jonaspluess/ultrasonic_phased_array/documentation/fachbericht/11_danksagung.tex

In erster Linie möchten wir uns bei unseren Projektbetreuern Herrn Matthias Meier und Herrn Prof. Dr. Richard Gut für Ihre grossartige Unterstützung während der vergangenen zwei Projekten bedanken. Mit ihren guten Ideen, der konstruktiven Kritik, dem Fachwissen und der unermüdlichen Hilfe wenn irgendwo Probleme auftraten haben sie massgeblich zum erfolgreichen und zufriedenstellenden Abschluss der Bachelorarbeit beigetragen.

Auch bei Frau Anita Gertiser möchten wir uns für das ausdauernde Korrekturlesen und die Unterstützung beim Strukturieren des Fachberichtes ganz herzlich bedanken.

Ebenfalls bei Herrn Christoph Biel möchten wir uns bedanken. Material- und PCB-Bestellungen wurden von ihm jeweils innert rekordverdächtig kurzer Zeit bearbeitet. Auch bei allen anderen Anliegen bezüglich Messgeräten und Bauteilen hat er uns stets ausgeholfen und mit seiner positiven Einstellung zu einem guten Arbeitsklima beigetragen.

Besonders möchten wir uns auch bei Herrn Christoph Mijnssen für die interessierte Teilnahme bedanken. Mit seinem Fachwissen in Gebieten der Akustik hat er uns stets unterstützt und auf neue Ideen gebracht. Auch spontane Bauteilbestellungen konnten wir dank ihm jederzeit erledigen. Ebenfalls möchten wir uns für das geduldige Gegenlesen des Fachberichtes bedanken.

Zudem möchten wir uns bei Herrn Prof. Dr. Urs Bopp und bei Herrn Peter Hug bedanken für die freundliche Erlaubnis, den reflexionsarmen Halbraum an der FHNW für Messungen benutzen zu können.
