jonaspluess/ultrasonic_phased_array/documentation/fachbericht/graphics/image_hardware_spannungsfolger.png

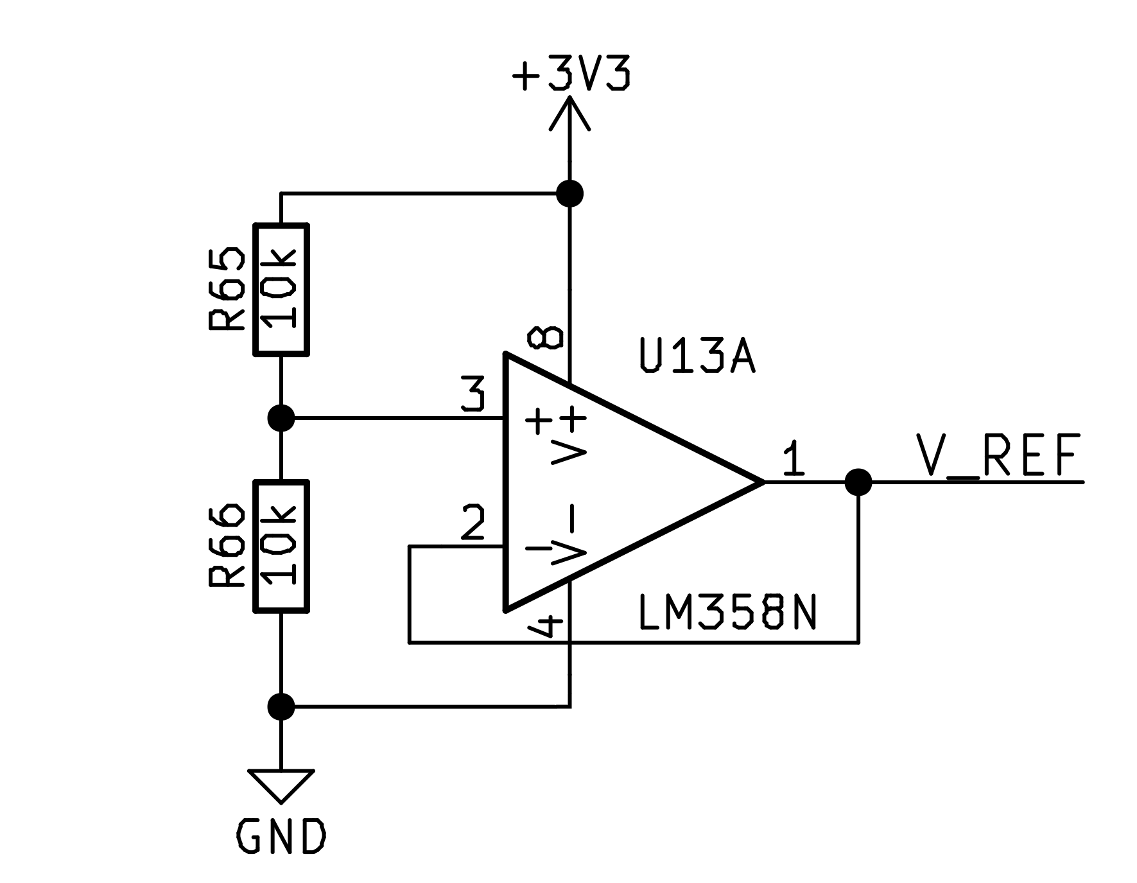
documentation/fachbericht/graphics/image_hardware_spannungsfolger.png
