jonaspluess/ultrasonic_phased_array/documentation/fachbericht/measurements/09_characteristic_aperture.txt

# 10 Grad, 8 Bursts
#	rect	cos	cos2	gauss
################################################################################
-45	0.544	0.287	0.332	0.325
-44	0.537	0.276	0.314	0.320
-43	0.503	0.277	0.303	0.297
-42	0.440	0.246	0.283	0.288
-41	0.402	0.241	0.273	0.275
-40	0.366	0.258	0.284	0.277
-39	0.311	0.236	0.273	0.288
-38	0.292	0.236	0.269	0.287
-37	0.344	0.244	0.284	0.293
-36	0.360	0.264	0.280	0.288
-35	0.434	0.280	0.277	0.267
-34	0.493	0.284	0.271	0.257
-33	0.537	0.304	0.276	0.273
-32	0.577	0.313	0.283	0.280
-31	0.591	0.327	0.297	0.298
-30	0.578	0.313	0.311	0.298
-29	0.537	0.313	0.317	0.313
-28	0.502	0.308	0.318	0.322
-27	0.434	0.293	0.317	0.320
-26	0.343	0.280	0.320	0.320
-25	0.293	0.288	0.305	0.320
-24	0.273	0.287	0.324	0.320
-23	0.337	0.284	0.316	0.312
-22	0.423	0.298	0.320	0.324
-21	0.503	0.293	0.332	0.320
-20	0.587	0.307	0.331	0.316
-19	0.623	0.303	0.337	0.301
-18	0.680	0.300	0.363	0.307
-17	0.666	0.338	0.374	0.310
-16	0.609	0.378	0.376	0.320
-15	0.516	0.407	0.353	0.320
-14	0.409	0.446	0.344	0.326
-13	0.422	0.485	0.342	0.327
-12	0.443	0.497	0.331	0.320
-11	0.531	0.520	0.336	0.320
-10	0.728	0.516	0.347	0.320
-9	0.927	0.472	0.357	0.408
-8	1.08	0.448	0.404	0.523
-7	1.16	0.433	0.511	0.600
-6	1.15	0.415	0.667	0.755
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
