jonaspluess/ultrasonic_phased_array/documentation/fachbericht/measurements/09_characteristic_module.txt

# 8 Bursts
################################################################################
-45	0.409
-44	0.404
-43	0.440
-42	0.440
-41	0.456
-40	0.471
-39	0.512
-38	0.514
-37	0.515
-36	0.520
-35	0.529
-34	0.532
-33	0.547
-32	0.573
-31	0.552
-30	0.578
-29	0.600
-28	0.613
-27	0.619
-26	0.621
-25	0.662
-24	0.676
-23	0.698
-22	0.711
-21	0.729
-20	0.753
-19	0.753
-18	0.754
-17	0.741
-16	0.741
-15	0.724
-14	0.705
-13	0.697
-12	0.693
-11	0.683
-10	0.677
-9	0.674
-8	0.680
-7	0.655
-6	0.643
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
