jonaspluess/ultrasonic_phased_array/documentation/fachbericht/measurements/09_characteristic_rect.txt

# 8 Bursts
#	0 deg	10 deg	20 deg	30 deg
################################################################################
-45	0.403	0.544	0.362	0.525
-44	0.456	0.537	0.352	0.442
-43	0.520	0.503	0.332	0.381
-42	0.560	0.440	0.320	0.423
-41	0.577	0.402	0.362	0.487
-40	0.552	0.366	0.402	0.555
-39	0.514	0.311	0.443	0.567
-38	0.476	0.292	0.496	0.557
-37	0.414	0.344	0.521	0.526
-36	0.359	0.360	0.543	0.524
-35	0.360	0.434	0.583	0.566
-34	0.368	0.493	0.581	0.584
-33	0.415	0.537	0.543	0.572
-32	0.440	0.577	0.517	0.541
-31	0.520	0.591	0.446	0.482
-30	0.600	0.578	0.383	0.442
-29	0.672	0.537	0.336	0.449
-28	0.684	0.502	0.320	0.466
-27	0.688	0.434	0.342	0.476
-26	0.680	0.343	0.373	0.451
-25	0.627	0.293	0.406	0.402
-24	0.544	0.273	0.440	0.333
-23	0.440	0.337	0.492	0.292
-22	0.360	0.423	0.527	0.308
-21	0.257	0.503	0.540	0.351
-20	0.317	0.587	0.557	0.397
-19	0.477	0.623	0.548	0.434
-18	0.640	0.680	0.517	0.422
-17	0.845	0.666	0.455	0.367
-16	0.992	0.609	0.376	0.322
-15	1.09	0.516	0.286	0.323
-14	1.14	0.409	0.311	0.382
-13	1.09	0.422	0.366	0.533
-12	1.00	0.443	0.444	0.601
-11	0.827	0.531	0.551	0.633
-10	0.600	0.728	0.617	0.616
-9	0.473	0.927	0.653	0.571
-8	0.763	1.08	0.622	0.475
-7	1.20	1.16	0.568	0.306
-6	1.72	1.15	0.457	0.295
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
