jonaspluess/ultrasonic_phased_array/documentation/fachbericht/graphics/plot_test_characteristic_aperture_0_cartesian.png

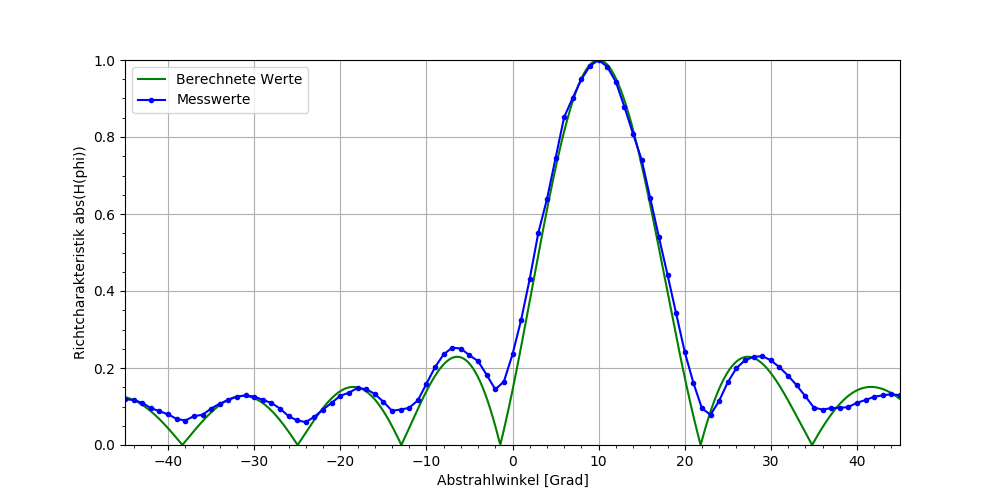
documentation/fachbericht/graphics/plot_test_characteristic_aperture_0_cartesian.png
