jonaspluess/ultrasonic_phased_array/documentation/fachbericht/graphics/plot_test_characteristic_module.png

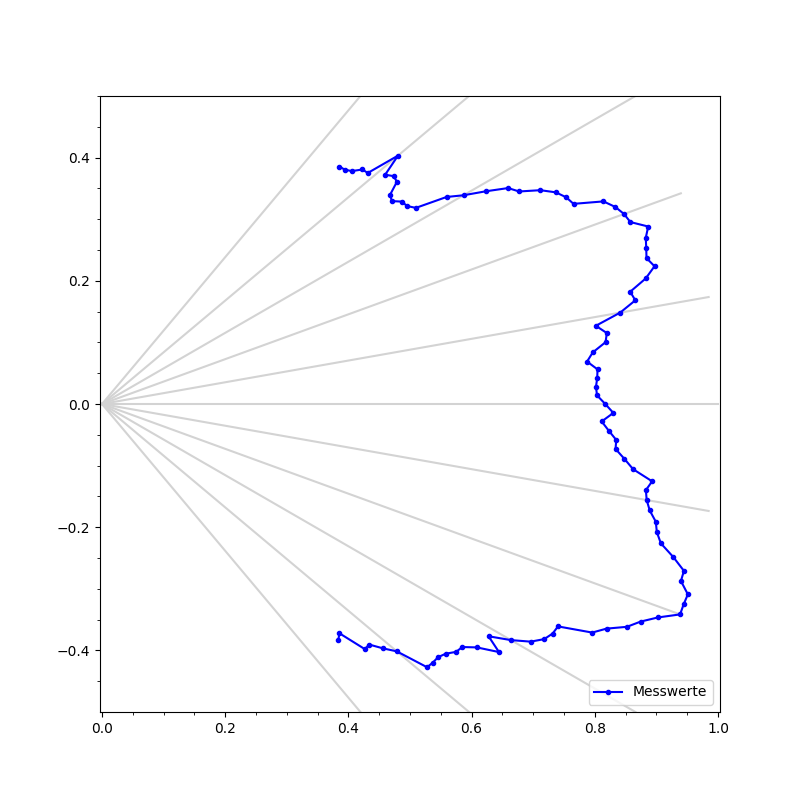
documentation/fachbericht/graphics/plot_test_characteristic_module.png
