jonaspluess/ultrasonic_phased_array/documentation/fachbericht/graphics/plot_test_characteristic_rect_30_cartesian_log.png

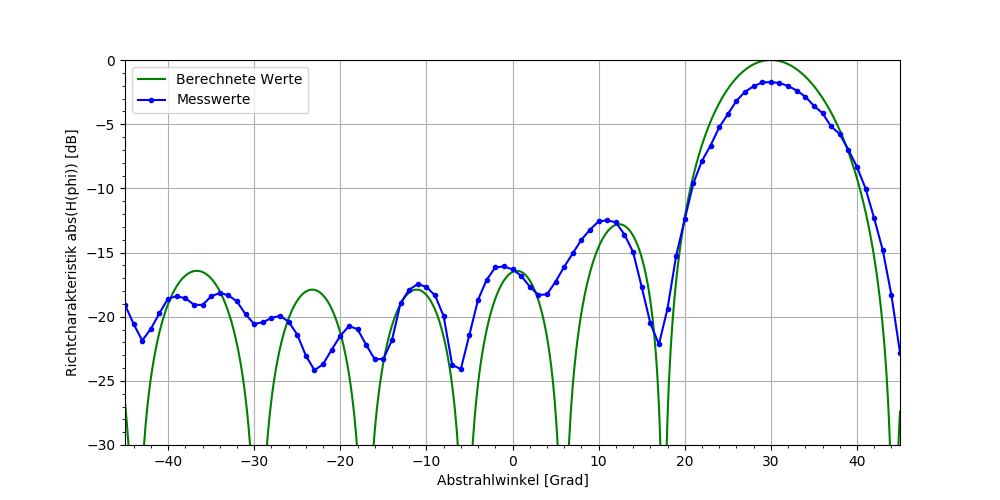
documentation/fachbericht/graphics/plot_test_characteristic_rect_30_cartesian_log.png
