jonaspluess/ultrasonic_phased_array/hardware/external_module/ir_adapter/plot/pcb-B.Cu.pdf

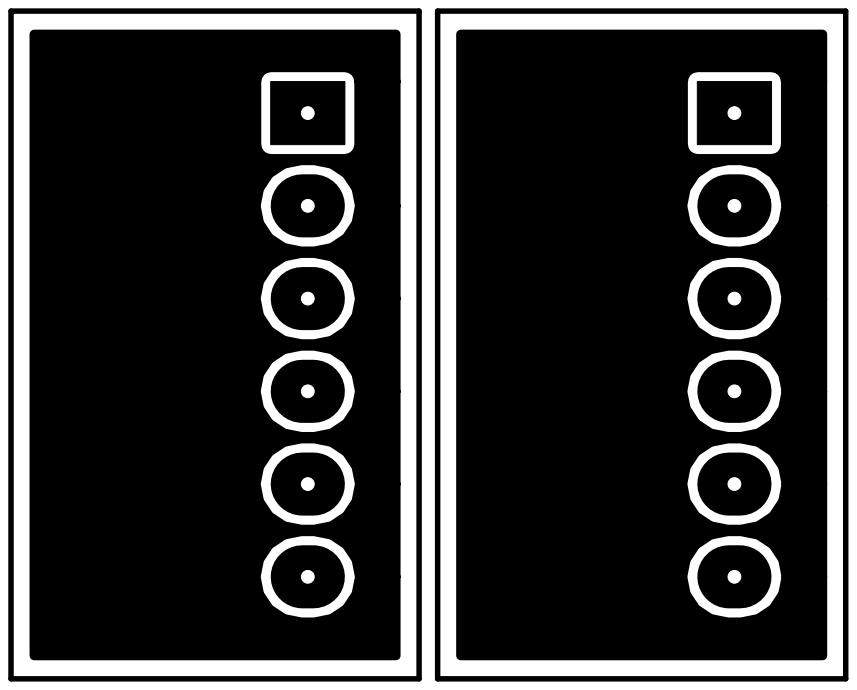
[picture p97: page 1]
