jonaspluess/ultrasonic_phased_array/hardware/external_module/ir_adapter/plot/pcb-F.Cu.pdf

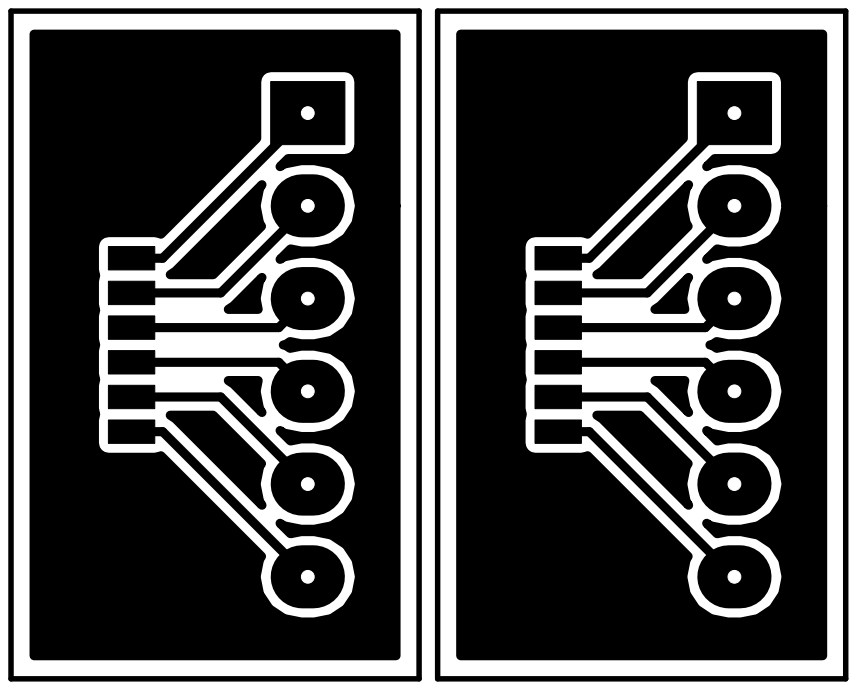
[picture p98: page 1]
