jonaspluess/ultrasonic_phased_array/documentation/simulationen/ltspice_simulation/P6.asc

C1: cap; 100n
C2: cap; 100n
C3: cap; 100n
C4: cap; 100n
R1: res; 1.2e3
R2: res; 20k
R3: res; 100
R4: res; 100
R5: res; 10k
R6: res; 100
U1: opamp2; OPA350
U2: opamp2; OPA350
V1: voltage; SINE(0 1e-3 40e3 0 0 0 40)
V2: voltage; 3.3; Rser=0.01
V3: voltage; 1.65; Rser=0.01
Named nets: 0, piezo, 3.3V, v_ref, out_ch1
.tran 1e-3
.INCLUDE OPA350.mod
