jonaspluess/ultrasonic_phased_array/hardware/ultrasonic_controller_v0.2/pcb.kicad_pcb

## KiCad design hardware/ultrasonic_controller_v0.2/pcb.kicad_pcb (2017-04-01)

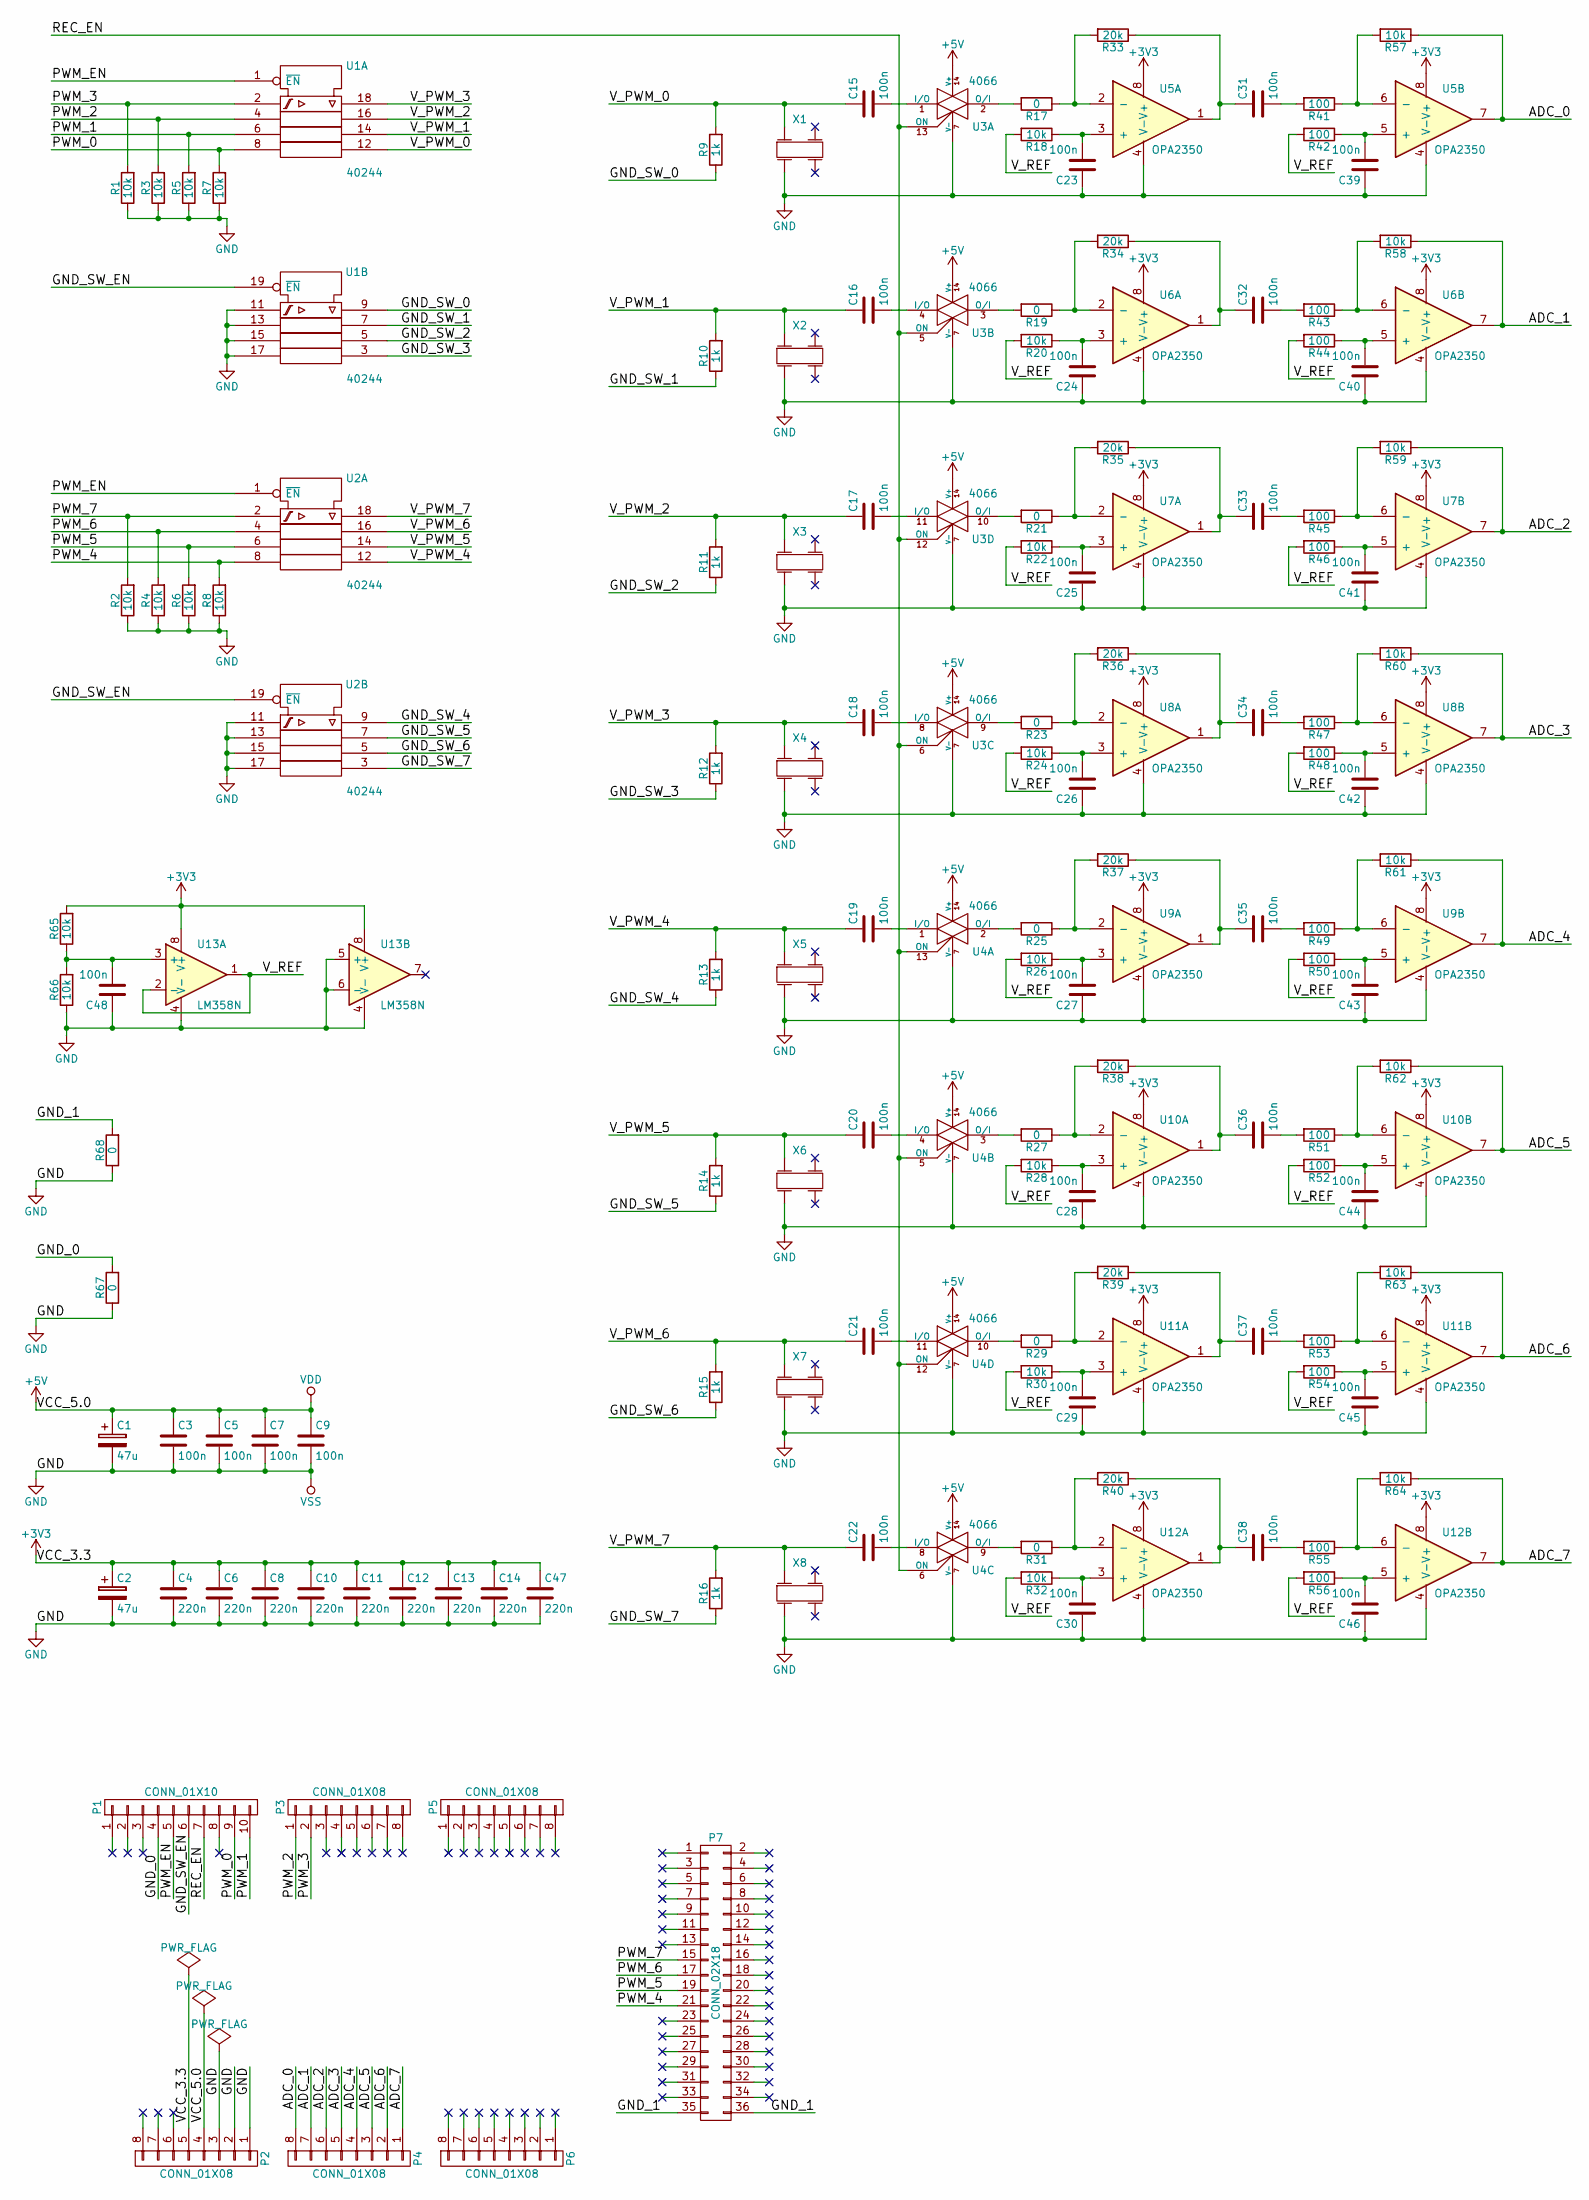
[picture p99: schematic pcb.sch]

Parts:
C1, C2: 47u; c_elec_6.3x5.8
C3, C5, C7, C9, C15, C16, C17, C18, C19, C20, C21, C22, C23, C24, C25, C26, C27, C28, C29, C30, C31, C32, C33, C34, C35, C36, C37, C38, C39, C40, C41, C42, C43, C44, C45, C46, C48: 100n; C_0805
C4, C6, C8, C10, C11, C12, C13, C14, C47: 220n; C_0805
P1: CONN_01X10; Pin_Header_Straight_1x10
P2, P3, P4, P5, P6: CONN_01X08; Pin_Header_Straight_1x08
P7: CONN_02X18; Pin_Header_Straight_2x18
R1, R2, R3, R4, R5, R6, R7, R8, R18, R20, R22, R24, R26, R28, R30, R32, R57, R58, R59, R60, R61, R62, R63, R64, R65, R66: 10k; R_0805
R9, R10, R11, R12, R13, R14, R15, R16: 1k; R_0805
R17, R19, R21, R23, R25, R27, R29, R31, R67, R68: 0; R_0805
R33, R34, R35, R36, R37, R38, R39, R40: 20k; R_0805
R41, R42, R43, R44, R45, R46, R47, R48, R49, R50, R51, R52, R53, R54, R55, R56: 100; R_0805
U1, U2: 40244; SOIC-20W_7.5x12.8mm_Pitch1.27mm
U3, U4: 4066; SOIC-14_N
U5, U6, U7, U8, U9, U10, U11, U12: OPA2350; SOIC-8_3.9x4.9mm_Pitch1.27mm
U13: LM358N; SOIC-8_3.9x4.9mm_Pitch1.27mm
X1, X2, X3, X4, X5, X6, X7, X8: PiezoelectricCrystal-TwoPairsOfelectrodes_EN60617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; murata_ultrasonic_transducer

Connections:
+3V3: C2.1, C4.1, C6.1, C8.1, C10.1, C11.1, C12.1, C13.1, C14.1, C47.1, P2.5, R65.2, U5.8 (V+), U6.8 (V+), U7.8 (V+), U8.8 (V+), U9.8 (V+), U10.8 (V+), U11.8 (V+), U12.8 (V+), U13.8 (V+)
+5V: C1.1, C3.1, C5.1, C7.1, C9.1, P2.4, U1.20 (Vdd), U2.20 (Vdd), U3.14 (V+), U4.14 (V+)
/ADC_0: P4.8, R57.1, U5.7
/ADC_1: P4.7, R58.1, U6.7
/ADC_2: P4.6, R59.1, U7.7
/ADC_3: P4.5, R60.1, U8.7
/ADC_4: P4.4, R61.1, U9.7
/ADC_5: P4.3, R62.1, U10.7
/ADC_6: P4.2, R63.1, U11.7
/ADC_7: P4.1, R64.1, U12.7
/GND_0: P1.4, R67.2
/GND_1: P7.35, P7.36, R68.2
/GND_SW_0: R9.1, U1.9
/GND_SW_1: R10.1, U1.7
/GND_SW_2: R11.1, U1.5
/GND_SW_3: R12.1, U1.3
/GND_SW_4: R13.1, U2.9
/GND_SW_5: R14.1, U2.7
/GND_SW_6: R15.1, U2.5
/GND_SW_7: R16.1, U2.3
/GND_SW_EN: P1.6, U1.19 (~EN), U2.19 (~EN)
/PWM_0: P1.9, R7.2, U1.8
/PWM_1: P1.10, R5.2, U1.6
/PWM_2: P3.1, R3.2, U1.4
/PWM_3: P3.2, R1.2, U1.2
/PWM_4: P7.21, R8.2, U2.8
/PWM_5: P7.19, R6.2, U2.6
/PWM_6: P7.17, R4.2, U2.4
/PWM_7: P7.15, R2.2, U2.2
/PWM_EN: P1.5, U1.1 (~EN), U2.1 (~EN)
/REC_EN: P1.7, U3.5 (ON), U3.6 (ON), U3.12 (ON), U3.13 (ON), U4.5 (ON), U4.6 (ON), U4.12 (ON), U4.13 (ON)
/V_PWM_0: C15.1, R9.2, U1.12, X1.1
/V_PWM_1: C16.1, R10.2, U1.14, X2.1
/V_PWM_2: C17.1, R11.2, U1.16, X3.1
/V_PWM_3: C18.1, R12.2, U1.18, X4.1
/V_PWM_4: C19.1, R13.2, U2.12, X5.1
/V_PWM_5: C20.1, R14.2, U2.14, X6.1
/V_PWM_6: C21.1, R15.2, U2.16, X7.1
/V_PWM_7: C22.1, R16.2, U2.18, X8.1
/V_REF: R18.2, R20.2, R22.2, R24.2, R26.2, R28.2, R30.2, R32.2, R42.2, R44.2, R46.2, R48.2, R50.2, R52.2, R54.2, R56.2, U13.1, U13.2 (-)
GND: C1.2, C2.2, C3.2, C4.2, C5.2, C6.2, C7.2, C8.2, C9.2, C10.2, C11.2, C12.2, C13.2, C14.2, C23.1, C24.1, C25.1, C26.1, C27.1, C28.1, C29.1, C30.1, C39.1, C40.1, C41.1, C42.1, C43.1, C44.1, C45.1, C46.1, C47.2, C48.1, P2.1, P2.2, P2.3, R1.1, R2.1, R3.1, R4.1, R5.1, R6.1, R7.1, R8.1, R66.1, R67.1, R68.1, U1.10 (Vss), U1.11, U1.13, U1.15, U1.17, U2.10 (Vss), U2.11, U2.13, U2.15, U2.17, U3.7 (V-), U4.7 (V-), U5.4 (V-), U6.4 (V-), U7.4 (V-), U8.4 (V-), U9.4 (V-), U10.4 (V-), U11.4 (V-), U12.4 (V-), U13.4 (V-), U13.5 (+), U13.6 (-), X1.3, X2.3, X3.3, X4.3, X5.3, X6.3, X7.3, X8.3
unnamed: C15.2, U3.1 (I/O)
unnamed: C16.2, U3.4 (I/O)
unnamed: C17.2, U3.11 (I/O)
unnamed: C18.2, U3.8 (I/O)
unnamed: C19.2, U4.1 (I/O)
unnamed: C20.2, U4.4 (I/O)
unnamed: C21.2, U4.11 (I/O)
unnamed: C22.2, U4.8 (I/O)
unnamed: C23.2, R18.1, U5.3 (+)
unnamed: C24.2, R20.1, U6.3 (+)
unnamed: C25.2, R22.1, U7.3 (+)
unnamed: C26.2, R24.1, U8.3 (+)
unnamed: C27.2, R26.1, U9.3 (+)
unnamed: C28.2, R28.1, U10.3 (+)
unnamed: C29.2, R30.1, U11.3 (+)
unnamed: C30.2, R32.1, U12.3 (+)
unnamed: C31.1, R33.1, U5.1
unnamed: C31.2, R41.2
unnamed: C32.1, R34.1, U6.1
unnamed: C32.2, R43.2
unnamed: C33.1, R35.1, U7.1
unnamed: C33.2, R45.2
unnamed: C34.1, R36.1, U8.1
unnamed: C34.2, R47.2
unnamed: C35.1, R37.1, U9.1
unnamed: C35.2, R49.2
unnamed: C36.1, R38.1, U10.1
unnamed: C36.2, R51.2
unnamed: C37.1, R39.1, U11.1
unnamed: C37.2, R53.2
unnamed: C38.1, R40.1, U12.1
unnamed: C38.2, R55.2
unnamed: C39.2, R42.1, U5.5 (+)
unnamed: C40.2, R44.1, U6.5 (+)
unnamed: C41.2, R46.1, U7.5 (+)
unnamed: C42.2, R48.1, U8.5 (+)
unnamed: C43.2, R50.1, U9.5 (+)
unnamed: C44.2, R52.1, U10.5 (+)
unnamed: C45.2, R54.1, U11.5 (+)
unnamed: C46.2, R56.1, U12.5 (+)
unnamed: C48.2, R65.1, R66.2, U13.3 (+)
unnamed: R17.1, R33.2, U5.2 (-)
unnamed: R17.2, U3.2 (O/I)
unnamed: R19.1, R34.2, U6.2 (-)
unnamed: R19.2, U3.3 (O/I)
unnamed: R21.1, R35.2, U7.2 (-)
unnamed: R21.2, U3.10 (O/I)
unnamed: R23.1, R36.2, U8.2 (-)
unnamed: R23.2, U3.9 (O/I)
unnamed: R25.1, R37.2, U9.2 (-)
unnamed: R25.2, U4.2 (O/I)
unnamed: R27.1, R38.2, U10.2 (-)
unnamed: R27.2, U4.3 (O/I)
unnamed: R29.1, R39.2, U11.2 (-)
unnamed: R29.2, U4.10 (O/I)
unnamed: R31.1, R40.2, U12.2 (-)
unnamed: R31.2, U4.9 (O/I)
unnamed: R41.1, R57.2, U5.6 (-)
unnamed: R43.1, R58.2, U6.6 (-)
unnamed: R45.1, R59.2, U7.6 (-)
unnamed: R47.1, R60.2, U8.6 (-)
unnamed: R49.1, R61.2, U9.6 (-)
unnamed: R51.1, R62.2, U10.6 (-)
unnamed: R53.1, R63.2, U11.6 (-)
unnamed: R55.1, R64.2, U12.6 (-)

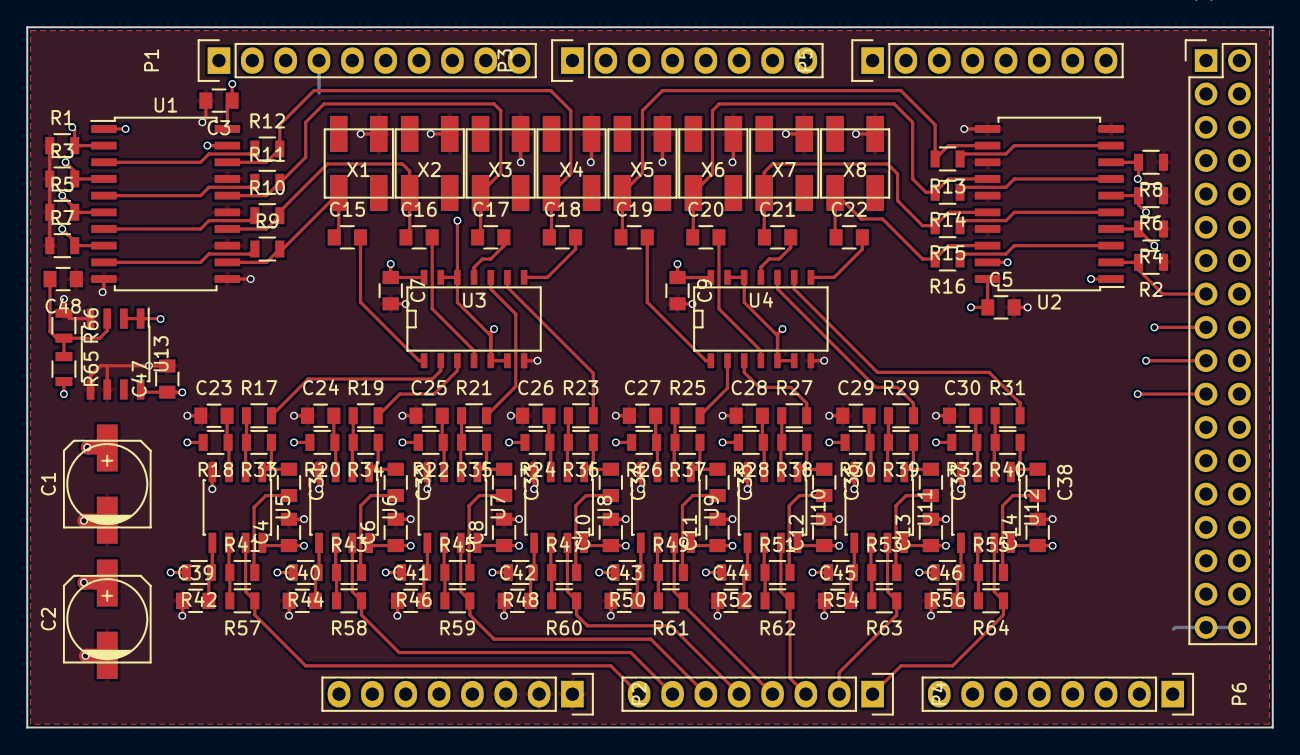
[picture p100: board hardware/ultrasonic_controller_v0.2/pcb.kicad_pcb from above]

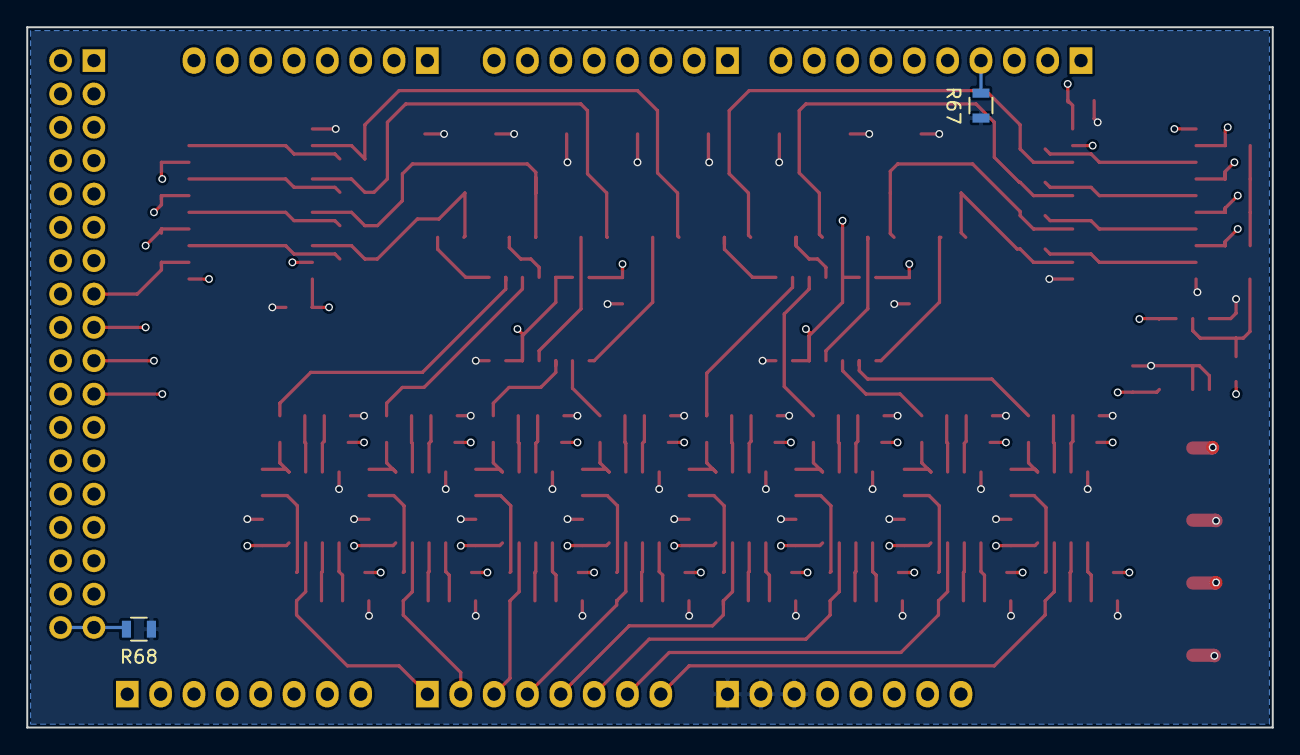
[picture p101: board hardware/ultrasonic_controller_v0.2/pcb.kicad_pcb from below]

Board: 4 copper layers, 94.9 x 53.3 mm, 144 parts (2 on the bottom side), 106 nets.
