jonaspluess/ultrasonic_phased_array/hardware/ultrasonic_controller_v0.1/ultrasonic_controller.kicad_pcb

## KiCad design hardware/ultrasonic_controller_v0.1/ultrasonic_controller.kicad_pcb (2017-04-01, an earlier design)

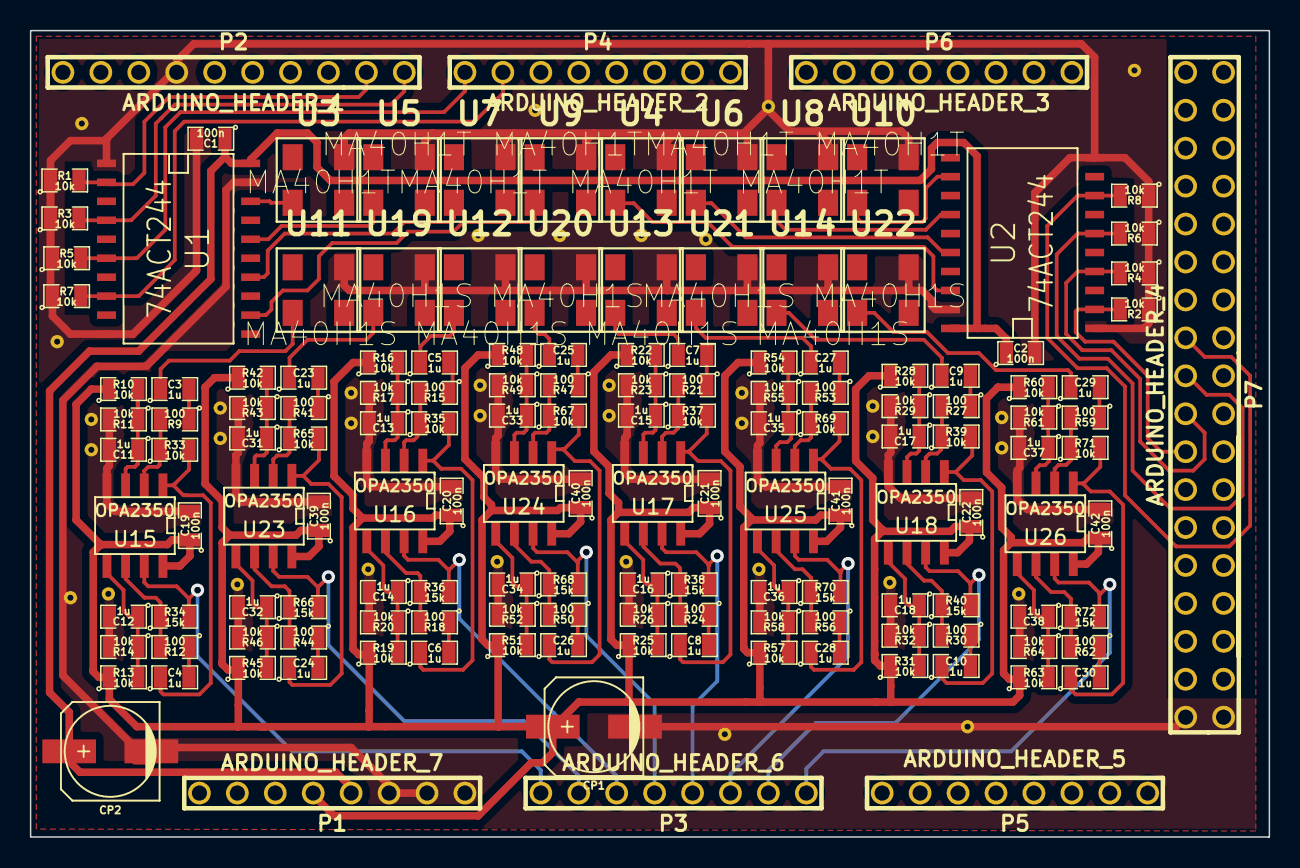
[picture p102: board ultrasonic_controller.kicad_pcb from above]

Board: 2 copper layers, 82.9 x 54.0 mm, 188 parts (0 on the bottom side), 91 nets.

Parts:
C1, C2, C19, C20, C21, C22, C39, C40, C41, C42: 100n; SM0805
C3, C4, C5, C6, C7, C8, C9, C10, C11, C12, C13, C14, C15, C16, C17, C18, C23, C24, C25, C26, C27, C28, C29, C30, C31, C32, C33, C34, C35, C36, C37, C38: 1u; SM0805
CP1, CP2: 10u; c_elec_6.3x5.8
GroundVia: VAL**; GroundVia
GroundVia#2, GroundVia#3, GroundVia#4, GroundVia#5, GroundVia#6, GroundVia#7, GroundVia#8, GroundVia#9, GroundVia#10, GroundVia#11, GroundVia#12, GroundVia#13, GroundVia#14, GroundVia#15, GroundVia#16, GroundVia#17, GroundVia#18, GroundVia#19, GroundVia#20, GroundVia#21, GroundVia#22, GroundVia#23, GroundVia#24, GroundVia#25, GroundVia#26, GroundVia#27, GroundVia#28, GroundVia#29, GroundVia#30, GroundVia#31, GroundVia#32, GroundVia#33, GroundVia#34, GroundVia#35, GroundVia#36, GroundVia#37, GroundVia#38, GroundVia#39: VAL**; GroundVia
P1: ARDUINO_HEADER_7; pin_array_8x1
P2: ARDUINO_HEADER_1; pin_array_10x1
P3: ARDUINO_HEADER_6; pin_array_8x1
P4: ARDUINO_HEADER_2; pin_array_8x1
P5: ARDUINO_HEADER_5; pin_array_8x1
P6: ARDUINO_HEADER_3; pin_array_8x1
P7: ARDUINO_HEADER_4; pin_array_18x2
R1, R2, R3, R4, R5, R6, R7, R8, R10, R11, R13, R14, R16, R17, R19, R20, R22, R23, R25, R26, R28, R29, R31, R32, R33, R35, R37, R39, R42, R43, R45, R46, R48, R49, R51, R52, R54, R55, R57, R58, R60, R61, R63, R64, R65, R67, R69, R71: 10k; SM0805
R9, R12, R15, R18, R21, R24, R27, R30, R41, R44, R47, R50, R53, R56, R59, R62: 100; SM0805
R34, R36, R38, R40, R66, R68, R70, R72: 15k; SM0805
U1, U2: 74ACT244; SO20L
U3, U4, U5, U6, U7, U8, U9, U10: MA40H1T; 81-MA4OH1S
U11, U12, U13, U14, U19, U20, U21, U22: MA40H1S; 81-MA4OH1S
U15, U16, U17, U18, U23, U24, U25, U26: OPA2350; SOIC-8_N

Connections:
/5V: C1.1, C2.1, CP2.1, P1.4, U1.20, U2.20
/ADC_0: P3.8, R34.2, U15.7
/ADC_0_X: C4.1, R33.2, U15.1
/ADC_1: P3.7, R66.2, U23.7
/ADC_1_X: C24.1, R65.2, U23.1
/ADC_2: P3.6, R36.2, U16.7
/ADC_2_X: C6.1, R35.2, U16.1
/ADC_3: P3.5, R68.2, U24.7
/ADC_3_X: C26.1, R67.2, U24.1
/ADC_4: P3.4, R38.2, U17.7
/ADC_4_X: C8.1, R37.2, U17.1
/ADC_5: P3.3, R70.2, U25.7
/ADC_5_X: C28.1, R69.2, U25.1
/ADC_6: P3.2, R40.2, U18.7
/ADC_6_X: C10.1, R39.2, U18.1
/ADC_7: P3.1, R72.2, U26.7
/ADC_7_X: C30.1, R71.2, U26.1
/PWM_0: P2.9, R1.2, U1.2
/PWM_1: P2.10, R3.2, U1.4
/PWM_2: P4.1, R5.2, U1.6
/PWM_3: P4.2, R7.2, U1.8
/PWM_4: P7.21, R2.2, U2.2
/PWM_5: P7.19, R4.2, U2.4
/PWM_6: P7.17, R6.2, U2.6
/PWM_7: P7.15, R8.2, U2.8
/VCC: C19.1, C20.1, C21.1, C22.1, C39.1, C40.1, C41.1, C42.1, CP1.1, P1.5, R10.1, R13.1, R16.1, R19.1, R22.1, R25.1, R28.1, R31.1, R42.1, R45.1, R48.1, R51.1, R54.1, R57.1, R60.1, R63.1, U15.8, U16.8, U17.8, U18.8, U23.8, U24.8, U25.8, U26.8
GND: C1.2, C2.2, C11.2, C12.2, C13.2, C14.2, C15.2, C16.2, C17.2, C18.2, C19.2, C20.2, C21.2, C22.2, C31.2, C32.2, C33.2, C34.2, C35.2, C36.2, C37.2, C38.2, C39.2, C40.2, C41.2, C42.2, CP1.2, CP2.2, GroundVia.1, GroundVia#2.1, GroundVia#3.1, GroundVia#4.1, GroundVia#5.1, GroundVia#6.1, GroundVia#7.1, GroundVia#8.1, GroundVia#9.1, GroundVia#10.1, GroundVia#11.1, GroundVia#12.1, GroundVia#13.1, GroundVia#14.1, GroundVia#16.1, GroundVia#17.1, GroundVia#18.1, GroundVia#19.1, GroundVia#20.1, GroundVia#21.1, GroundVia#22.1, GroundVia#23.1, GroundVia#24.1, GroundVia#25.1, GroundVia#26.1, GroundVia#27.1, GroundVia#28.1, GroundVia#29.1, GroundVia#31.1, GroundVia#32.1, GroundVia#34.1, GroundVia#35.1, GroundVia#36.1, GroundVia#37.1, GroundVia#38.1, GroundVia#39.1, P1.1, P1.2, P1.3, P2.4, P7.35, P7.36, R1.1, R2.1, R3.1, R4.1, R5.1, R6.1, R7.1, R8.1, R11.2, R14.2, R17.2, R20.2, R23.2, R26.2, R29.2, R32.2, R43.2, R46.2, R49.2, R52.2, R55.2, R58.2, R61.2, R64.2, U1.1, U1.10, U1.19, U2.1, U2.10, U2.19, U3.3, U4.3, U5.3, U6.3, U7.3, U8.3, U9.3, U10.3, U11.3, U12.3, U13.3, U14.3, U15.4, U16.4, U17.4, U18.4, U19.3, U20.3, U21.3, U22.3, U23.4, U24.4, U25.4, U26.4
unnamed: C35.1, R54.2, R55.1, U25.3
unnamed: R56.2, R70.1, U25.6
unnamed: R53.2, R69.1, U25.2
unnamed: C36.1, R57.2, R58.1, U25.5
unnamed: C9.1, U14.1
unnamed: C10.2, R30.1
unnamed: C9.2, R27.1
unnamed: C27.1, U21.1
unnamed: R30.2, R40.1, U18.6
unnamed: C18.1, R31.2, R32.1, U18.5
unnamed: R27.2, R39.1, U18.2
unnamed: C17.1, R28.2, R29.1, U18.3
unnamed: C7.1, U13.1
unnamed: C8.2, R24.1
unnamed: C7.2, R21.1
unnamed: R24.2, R38.1, U17.6
unnamed: R47.2, R67.1, U24.2
unnamed: R50.2, R68.1, U24.6
unnamed: C34.1, R51.2, R52.1, U24.5
unnamed: C27.2, R53.1
unnamed: C16.1, R25.2, R26.1, U17.5
unnamed: R21.2, R37.1, U17.2
unnamed: C28.2, R56.1
unnamed: C15.1, R22.2, R23.1, U17.3
unnamed: U1.14, U7.1
unnamed: U1.12, U9.1
unnamed: U2.12, U10.1
unnamed: U2.14, U8.1
unnamed: U2.18, U4.1
unnamed: U2.16, U6.1
unnamed: R59.2, R71.1, U26.2
unnamed: R62.2, R72.1, U26.6
unnamed: C29.2, R59.1
unnamed: C30.2, R62.1
unnamed: C29.1, U22.1
unnamed: C37.1, R60.2, R61.1, U26.3
unnamed: U1.18, U3.1
unnamed: U1.16, U5.1
unnamed: C38.1, R63.2, R64.1, U26.5
unnamed: R12.2, R34.1, U15.6
unnamed: R9.2, R33.1, U15.2
unnamed: C12.1, R13.2, R14.1, U15.5
unnamed: C3.1, U11.1
unnamed: C11.1, R10.2, R11.1, U15.3
unnamed: C4.2, R12.1
unnamed: C3.2, R9.1
unnamed: C5.1, U12.1
unnamed: C6.2, R18.1
unnamed: C5.2, R15.1
unnamed: C32.1, R45.2, R46.1, U23.5
unnamed: C14.1, R19.2, R20.1, U16.5
unnamed: C25.1, U20.1
unnamed: C33.1, R48.2, R49.1, U24.3
unnamed: C26.2, R50.1
unnamed: R18.2, R36.1, U16.6
unnamed: R15.2, R35.1, U16.2
unnamed: C13.1, R16.2, R17.1, U16.3
unnamed: C25.2, R47.1
unnamed: R44.2, R66.1, U23.6
unnamed: R41.2, R65.1, U23.2
unnamed: C31.1, R42.2, R43.1, U23.3
unnamed: C24.2, R44.1
unnamed: C23.2, R41.1
unnamed: C23.1, U19.1
