jonaspluess/ultrasonic_phased_array/hardware/external_module/ir_adapter/pcb.kicad_pcb

## KiCad design hardware/external_module/ir_adapter/pcb.kicad_pcb (2017-04-01)

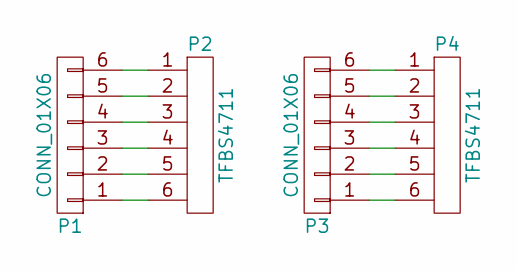
[picture p103: schematic pcb.sch]

Parts:
P1, P3: CONN_01X06; Pin_Header_Straight_1x06
P2, P4: TFBS4711

Connections:
unnamed: P1.1, P2.6
unnamed: P1.2, P2.5
unnamed: P1.3, P2.4
unnamed: P1.4, P2.3
unnamed: P1.5, P2.2
unnamed: P1.6, P2.1
unnamed: P3.1, P4.6
unnamed: P3.2, P4.5
unnamed: P3.3, P4.4
unnamed: P3.4, P4.3
unnamed: P3.5, P4.2
unnamed: P3.6, P4.1

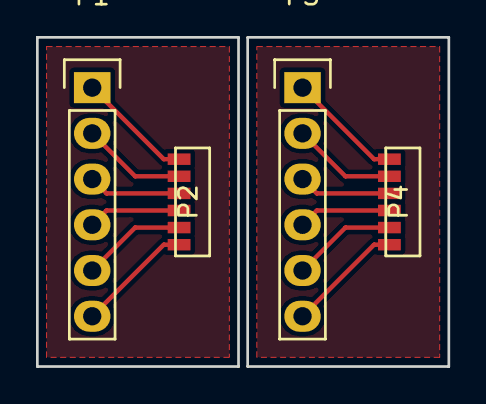
[picture p104: board hardware/external_module/ir_adapter/pcb.kicad_pcb from above]

Board: 2 copper layers, 22.9 x 18.3 mm, 4 parts (0 on the bottom side), 12 nets.
