jonaspluess/ultrasonic_phased_array/software/firmware_ultrasonic_controller/firmware/src/transmitter.h

/*******************************************************************************
 *
 * Copyright (C) 2016, 2017, Mijnssen Raphael, Pluess Jonas
 *
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
 ******************************************************************************/


#ifndef TRANSMITTER_H
#define TRANSMITTER_H


#include <asf.h>
#include <stdint.h>


/******************************************************************************/
#define TRANSMITTER_INIT_PIO(pio, reg) \
	(pio)->PIO_PER = (reg); \
	(pio)->PIO_OER = (reg); \
	(pio)->PIO_PUDR = (reg)

#define TRANSMITTER_SET_PIO(pio, reg) \
	(pio)->PIO_SODR = (reg)

#define TRANSMITTER_CLR_PIO(pio, reg) \
	(pio)->PIO_CODR = (reg)
/******************************************************************************/


#define NOP_1		__asm("nop")

#define NOP_2		__asm("nop"); \
			__asm("nop")

#define NOP_3		__asm("nop"); \
			__asm("nop"); \
			__asm("nop")

#define NOP_5		__asm("nop"); \
			__asm("nop"); \
			__asm("nop"); \
			__asm("nop"); \
			__asm("nop")

#define NOP_7		__asm("nop"); \
			__asm("nop"); \
			__asm("nop"); \
			__asm("nop"); \
			__asm("nop"); \
			__asm("nop"); \
			__asm("nop")

#define NOP_16		__asm("nop"); \
			__asm("nop"); \
			__asm("nop"); \
			__asm("nop"); \
			__asm("nop"); \
			__asm("nop"); \
			__asm("nop"); \
			__asm("nop"); \
			__asm("nop"); \
			__asm("nop"); \
			__asm("nop"); \
			__asm("nop"); \
			__asm("nop"); \
			__asm("nop"); \
			__asm("nop"); \
			__asm("nop")

#define NOP_17		__asm("nop"); \
			__asm("nop"); \
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
#define APERTURE_COS_2 2
#define APERTURE_GAUSS 3

#define STDEV_GAUSS 0.5


extern void transmitter_init(unsigned long frequency, unsigned long num_bursts, int aperture);
extern int transmitter_send(int angle);
extern int transmitter_send_ir(void);


#endif /* TRANSMITTER_H */
